Livfelix/STM32/Projeto_Modulo_Portatil_StrainGauge/BOM_FINAL_ADS1256_MSP2807.xlsx

SG6 - materiais para montagem mista (15/10/2026)
6 entradas, 9 gauges. Confirmado = declaração específica do usuário; inspeção física pendente.
Pendente não significa zero. Sem preços ou autonomia presumidos. Ver manual revisado e guias atuais.
ID | Componente | Necessário (un/conj) | Compra declarada | Qtd confirmada | Falta | Reserva | Fonte: especificação SG6 integridade/bateria, 15/10/2026, seções 2, 7 e 8; estoque declarado.
board | Placa integrada ADS1256+STM32F103C8 | 1 | Adquirida | 1 | 0 | 0 | J2 5V; Blue Pill avulsa reserva.
gauges | Gauge350ohms | 9 | Vários, sem limitação declarada | Pendente | Pendente | Pendente | 3 pares de flexão + 3 locais. GF/lote conferir. 12 para seis meias.
ina | CJMCU-333 | 6 | 6 confirmados pelo usuário | 6 | 0 | 0 | G físico100; Vref e3.3V abertos. Janela real medir.
opa | OPA2364AIDR SOIC-8 | 4 | 12 confirmados pelo usuário | 12 | 0 | 8 | 3 CIs para filtros + 1 monitor; oito reserva.
soic | Adaptador SOIC-8 ou PCB equivalente | 4 | Não informado | Pendente | Pendente | Pendente | Conferir disponibilidade e orientação dos quatro OPA.
ref1k | Referência1k /0.1% | 12 | Não confirmado para esta revisão | Pendente | Pendente | Pendente | Um par por canal, TCR compatível e acoplamento térmico. Não usar5%.
ra350 | RA350 /0.1% | 6 | Compra anterior declarada | Pendente | Pendente | Pendente | 6 montados nos seletores, 3 bypassados. Lista antiga18; recontar valor/tolerância.
selector | Seletor físico JP_QH | 6 | Não informado | Pendente | Pendente | Pendente | W1 em RA(Q) ou VEXC(H). Exige trocar sensor/fiação e recalibrar; não é J3.
filter_r | Resistor filtro2.15k | 12 | Compra anterior declarada | Pendente | Pendente | Pendente | 2 por canal; conferir valor/tolerância reais.
filter_220n | Capacitor filtro220nF | 6 | Compra anterior declarada | Pendente | Pendente | Pendente | C1 entre X e OUT, não GND. Conferir dielétrico/tolerância.
filter_100n | Capacitor filtro100nF | 6 | Compra anterior declarada | Pendente | Pendente | Pendente | C2 entre Y e AGND; não inclui desacoplamento.
monitor_r | Monitor VEXC2.2k /0.1% | 2 | Compra anterior declarada | Pendente | Pendente | Pendente | Par casado -> buffer -> IN7; fator nominal ADC0.49505.
battery_r | Monitor bateria 10 kΩ | 2 | Compra anterior declarada | Pendente | Pendente | Pendente | SW_BAT+ pós-chave -> 10k -> PB0 -> 10k -> GND; 100nF em PB0. Medir par/VDDA.
pull | Pull-up CS 10 kΩ | 3 | Compra anterior declarada | Pendente | Pendente | Pendente | LCD/toque/SD para 3,3V; descontar existentes. Com bateria: cinco 10k funcionais.
shunt | Shunt100k /0.1% | 1 | Compra anterior declarada | Pendente | Pendente | Pendente | Aplicador manual reutilizável no sensor. Medir valor real; UI100k nominal.
decouple_100n | Desacoplamento100nF INA/OPA | 10 | Compra anterior declarada | Pendente | Pendente | Pendente | 6 INA + 4 OPA; conferir caps onboard.
decouple_10u | Desacoplamento10uF INA/OPA | 10 | Compra anterior declarada | Pendente | Pendente | Pendente | 6 INA + 4 OPA; polaridade/tensão conforme rail5V.
extra_100n | Capacitor100nF extra | 5 | Compra anterior declarada | Pendente | Pendente | Pendente | Monitor VEXC, bateria, cluster, boost, SD.
analog_bulk | Cluster analógico47uF | 1 | Compra anterior declarada | Pendente | Pendente | Pendente | Pós-L1; tensão nominal compatível com5V.
boost_bulk | Boost100-470uF /10V | 1 | Compra anterior declarada | Pendente | Pendente | Pendente | Valor final depende de partida/estabilidade.
sd_bulk | SD47-100uF | 1 | Compra anterior declarada | Pendente | Pendente | Pendente | Próximo ao módulo3.3V; medir transientes.
lcd | MSP2807 + XPT2046 | 1 | Adquirida | 1 | 0 | 0 | VCC5V/J1 aberto; IO3.3V; slot SD tela sem uso.
sd | Módulo SD SPI3.3V | 1 | Adquirido | 1 | 0 | 0 | P9-1 VDD/P9-2 GND; PDF5V é outra variante.
card | Cartão SDHC FAT32 | 1 | Não informado | Pendente | Pendente | Pendente | 8-32GB inicial; validar latência/cartão; sem promessa de horas.
uart | USB-UART3.3V /921600 | 1 | Não informado | Pendente | Pendente | Pendente | PA9 -> RX e GND; TX/VCC abertos.
stlink | ST-Link V2 Mini | 1 | Adquirido | 1 | 0 | 0 | JTAG1 SWDIO7/SWCLK9/NRST15; clone não alimenta a placa.
boost | MT3608 | 1 | Adquirido | 1 | 0 | 0 | Regular5.00V; datasheet1.2MHz; medir ripple/corrente.
charger | TP4056 carregador 1S | 1 | Adquirido | 1 | 0 | 0 | Carga só OFF; LEDs visíveis. Revisão/proteção e corrente de carga a conferir; sem PowerPath.
protection | Proteção real Li-ion1S | 1 | Não comprovada no carregador | Pendente | Pendente | Pendente | Conferir descarga/curto e OUT protegido; não presumir PowerPath.
cell | Célula 18650 protegida + suporte | 1 | Suporte declarado; célula pendente | Pendente | Pendente | Pendente | Um conjunto. Modelo/capacidade/proteção/encaixe pendentes; medir autonomia e picos.
connector | Conjunto conector sensor 5 contatos | 6 | Compra anterior declarada | Pendente | Pendente | Pendente | 6 pares painel/cabo = 12 metades; 0,50 mm², trava/alívio. Vista/pinout e família após medir caixa.
cable | Cabo 4 vias + dreno, 0,50 mm², até 1 m | 6 | Cabo blindado existente; recontar trechos | Pendente | Pendente | Pendente | 3 ativas W1/W2/W3, quarta isolada nas duas pontas; dreno só no equipamento. 2 vias não atende.
front | PCB/perfboard front-end | 1 | Compra anterior declarada | Pendente | Pendente | Pendente | Dimensões/furação após medir módulos; sem CAD de fabricação.
case | Gabinete e chave ON/OFF | 1 | Compra anterior declarada | Pendente | Pendente | Pendente | Envelope proposto180x130x65mm; medir encaixe; chave após OUT+.
install | Adesivo, terminais, proteção gauges | 1 | Não confirmado | Pendente | Pendente | Pendente | Conjunto conforme material/temperatura; alívio de tração.
assembly | Fiação, headers, espaçadores, prensa-cabos | 1 | Compra anterior declarada | Pendente | Pendente | Pendente | Conjunto após levantamento físico; cotas finais pendentes.
ldo | AMS1117 externo | 0 | Adquirido | 1 | 0 | 1 | Reserva/alternativa SD após ensaio; nunca paralelizar saídas.
can | TJA1050 | 0 | Adquirido | 1 | 0 | 1 | Reserva; CAN não implementado.
rg_external | Rg externo 10 kΩ | 0 | Compra anterior declarada | Pendente | Pendente | Pendente | Não montar: CJMCU usa ajuste interno. Não confundir com os cinco 10k funcionais.
zener | Zener de entrada 3,3 V | 0 | Compra anterior declarada | Pendente | Pendente | Pendente | Não montar: fuga e limite inadequado não substituem janela ADC ou sequência OFF.
or_diode | Diodo OR antigo 1N5819 | 0 | Compra anterior declarada | Pendente | Pendente | Pendente | Não montar OR: queda nos rails; carga somente OFF, sem PowerPath.
