Livfelix/STM32/uploads/ADS1256+STM32F103数据采集板原理图.pdf

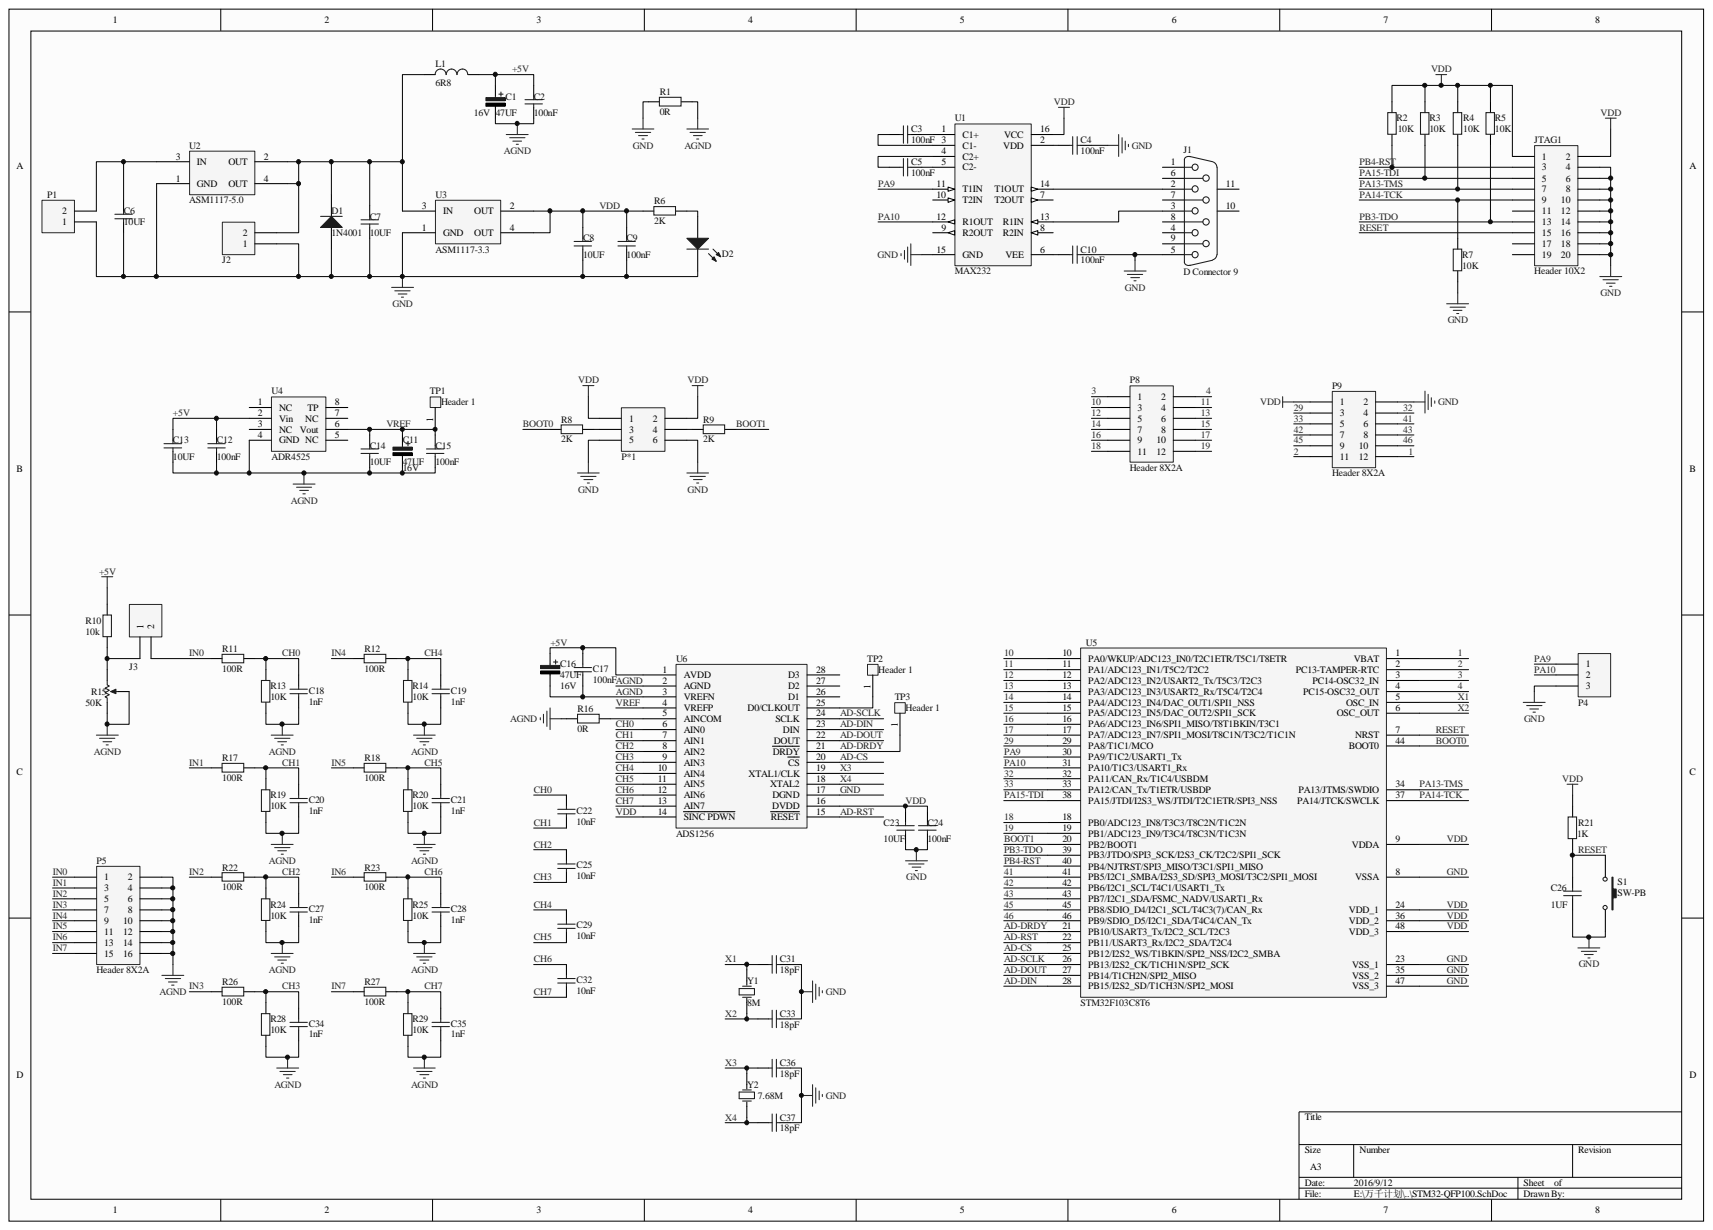
[picture p4: page 1]
