Livfelix/STM32/Projeto_Modulo_Portatil_StrainGauge/fw_pio/src/logo.c

/* gerado por tools/gen_logo.py */
#include <stdint.h>
const uint16_t logo_rgb565[120*60] = {
0x08A7,0x08A7,0x08A7,0x08A7,0x08A7,0x08A7,0x08A7,0x08A7,0x08A7,0x08A7,0x08A7,0x08A7,0x08A7,0x08A7,0x08A7,0x08A7,0x08A7,0x08A7,0x08A7,0x08A7,0x08A7,0x08A7,0x08A7,0x08A7,0x08A7,0x08A7,0x08A7,0x08A7,0x08A7,0x08A7,0x08A7,0x08A7,0x08A7,0x08A7,0x08A7,0x08A7,0x08A7,0x08A7,0x08A7,0x08A7,0x08A7,0x08A7,0x08A7,0x08A7,0x08A7,0x08A7,0x08A7,0x08A7,0x08A7,0x08A7,0x08A7,0x08A7,0x08A7,0x08A7,0x08A7,0x08A7,0x08A7,0x08A7,0x08A7,0x08A7,0x08A7,0x08A7,0x08A7,0x08A7,0x08A7,0x08A7,0x08A7,0x08A7,0x08A7,0x08A7,0x08A7,0x08A7,0x08A7,0x08A7,0x08A7,0x08A7,0x08A7,0x08A7,0x08A7,0x08A7,0x08A7,0x08A7,0x08A7,0x08A7,0x08A7,0x08A7,0x08A7,0x08A7,0x08A7,0x08A7,0x08A7,0x08A7,0x08A7,0x08A7,0x08A7,0x08A7,0x08A7,0x08A7,0x08A7,0x08A7,0x08A7,0x08A7,0x08A7,0x08A7,0x08A7,0x08A7,0x08A7,0x08A7,0x08A7,0x08A7,0x08A7,0x08A7,0x08A7,0x08A7,0x08A7,0x08A7,0x08A7,0x08A7,0x08A7,0x08A7,
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
0x116C,0xFE40,0x116C,0x116C,0x116C,0x116C,0x116C,0x116C,0x116C,0x116C,0x116C,0x116C,0x116C,0x116C,0x116C,0x116C,0x116C,0x116C,0x116C,0x116C,0x116C,0x116C,0x07FF,0x07FF,0x07FF,0x116C,0x116C,0x116C,0x116C,0x116C,0x116C,0x116C,0x116C,0x116C,0x116C,0x116C,0x07FF,0x07FF,0x07FF,0x116C,0x116C,0x116C,0x116C,0x116C,0x116C,0x116C,0x116C,0x116C,0x116C,0x116C,0x116C,0x116C,0x116C,0x116C,0x116C,0x116C,0x116C,0x116C,0x116C,0x116C,0x116C,0x116C,0x116C,0x116C,0x116C,0x116C,0x116C,0x116C,0x116C,0x116C,0x116C,0x116C,0x116C,0x116C,0x116C,0x116C,0x116C,0x116C,0x116C,0x116C,0x116C,0x116C,0x116C,0x116C,0x116C,0x116C,0x116C,0x116C,0x116C,0x116C,0x116C,0x116C,0x116C,0x116C,0x116C,0x116C,0x116C,0x116C,0x116C,0x116C,0x116C,0x116C,0x116C,0x116C,0x116C,0x116C,0x116C,0x116C,0x116C,0x116C,0x116C,0x116C,0x116C,0x116C,0x116C,0x116C,0x116C,0x116C,0xFE40,0x116C,
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
};
